Doooooooove/Medical-Electrical-Stimulator-STM32/hardware/README.md

# 硬件资料与连接

## 已包含的资料

- [电流板原理图](电流板原理图_Howland恒流源.pdf)：电压转电流与升压电路资料。
- [电流板 PCB 3D](电流板PCB_3D.pdf)：PCB 外观资料。
- [原型连线实拍](../docs/assets/prototype-bench.jpeg)：课程答辩第 18 页。
- [阻抗检测连接实拍](../docs/assets/impedance-bench.jpeg)：课程答辩第 11 页。

原 README 曾列出 STM32 核心板原理图，但当前仓库未包含该文件。板卡版本、完整 BOM、可编辑 PCB 工程和核心板原理图仍需后续补齐。

## 硬件链路

答辩材料中的驱动链路由 LM5158 升压级和 OPA551UA / BCP56 Howland 恒流级组成，标称升压轨为 54 V。实际输出能力取决于供电、负载与器件状态，不能仅用电源轨电压作为负载端能力指标。

负载电压通过 100 kΩ 与 4.7 kΩ 分压后送入 ADC。电阻负载与分压支路并联，固件对 104.7 kΩ 支路的影响进行补偿。

## 当前固件引脚

| 用途 | STM32 引脚 | 外设连接 |
| --- | --- | --- |
| 模拟控制 | PA4 / DAC1 | 恒流板控制输入 |
| 电压采样 | PA0 / ADC1_IN0 | 分压网络采样点 |
| 触屏发送 | PA2 / USART2_TX | 触屏 RX |
| 触屏接收 | PA3 / USART2_RX | 触屏 TX |
| 无线发送 | PB10 / USART3_TX | ESP32-C3 RX |
| 无线接收 | PB11 / USART3_RX | ESP32-C3 TX |
| 参考地 | GND | 按原理图和模块要求连接 |

两路 STM32 串口均为 9600 bps、8N1。ESP32-C3 实际串口管脚和模块供电应按具体板型核对，不从裸芯片名称推断模块接口。

## 台架记录

答辩第 8 页的标定使用标称 2.2 kΩ 电阻，课程任务要求中的负载为 2 kΩ，二者应分别记录。当前照片和表格未完整提供负载实测值、容差、探测位置及仪器设置，详见[实验记录](../docs/validation.md)。

本仓库按电阻负载教学原型说明，不提供人体连接或治疗操作指南。
