Doooooooove/Medical-Electrical-Stimulator-STM32/docs/assets/README.md

# 实物图片来源

以下图片直接从维护者提供的《工创答辩》PPTX 的内嵌媒体中提取，保留原始字节，不裁切、不重绘，不修改读数。答辩封面日期为 2026-10-10，源文件 SHA-256 记录于 [实验记录](../validation.md)。

| 仓库文件 | 答辩页码 | PPTX 内嵌媒体 |
| --- | --- | --- |
| [prototype-bench.jpeg](prototype-bench.jpeg) | 18 | ppt/media/image35.jpeg |
| [scope-square.jpeg](scope-square.jpeg) | 7；同图另见 10 | ppt/media/image18.jpeg |
| [scope-exponential.jpeg](scope-exponential.jpeg) | 7、15 | ppt/media/image19.jpeg |
| [touchscreen.png](touchscreen.png) | 9 | ppt/media/image21.png |
| [impedance-bench.jpeg](impedance-bench.jpeg) | 11 | ppt/media/image26.jpeg |

这些是课程历史照片，不表示当前源码已完成复测。照片来源与软件版本分别记录。

图片权利归原权利人所有；第三方仪器与部件标识仅随实物照片出现。本次整理不额外发布包含学号和团队分工页的完整 PPT。

## Extracted image SHA-256

```text
prototype-bench.jpeg: d52561f0c2eb018fa2cf3d38755b160d2dafed0dc0a3548ff5372a9f7d169658
scope-square.jpeg: 8931f059186a53c1ad5a8b8f80eaf74cf128d25edcdfc1fe09eeaeb757da040e
scope-exponential.jpeg: 681918e8823cc99c03120ba20e04e832273ad1942c9be3908cb53f4bc3bec9cc
touchscreen.png: 769799a62ef4ccf7984dece17407666eeb5f1e26c6af2486228516d80676e821
impedance-bench.jpeg: 8b1d1d3e5d0a7fedc9b798ba3a578a7925597c38ae3c7afd09415009087dfd3e
```
