Doooooooove/Medical-Electrical-Stimulator-STM32/docs/portfolio.md

# 项目简述：STM32 可编程电刺激教学原型

## 项目背景与个人工作

南京航空航天大学智能医疗实践课程，2026-10-10 结题答辩。维护者高申独立完成硬件搭建与焊接、固件集成、触屏和无线模块联调、示波器测量及标定，使用 AI 辅助代码开发。

项目目标是把 MCU 控制、恒流驱动、采样和交互接通，形成可操作的教学原型。

## 实现内容

| 工作 | 具体实现 | 可查看材料 |
| --- | --- | --- |
| 模拟链路与硬件联调 | STM32、Howland 恒流级、分压采样及外设连接 | [连线实拍](assets/prototype-bench.jpeg)、[硬件资料](../hardware/README.md) |
| 实时输出 | TIM1 回调计算波形并更新片内 DAC | [固件说明](../firmware/README.md) |
| 标定补偿 | 十一点 DAC 表及线性插值 | [设计说明](医疗电刺激系统设计与实验报告.md) |
| 采样计算 | ADC 均值、分压还原与并联支路补偿 | [设计说明](医疗电刺激系统设计与实验报告.md) |
| 交互集成 | 串口屏、ESP32-C3 网页与短命令协议 | [HMI](../hmi/README.md)、[无线协议](../wireless/readme.md) |
| 测量与记录 | 方波及指数波实拍，电流标定表 | [验证记录](validation.md) |

## 实验结果及边界

答辩第 8 页包含标称 2.2 kΩ 负载下十个 1–10 mA 设定点。按记录电压重新计算，最大绝对相对偏差约 0.0455%。该数值限于这组表格，不包含负载容差与仪器不确定度，不作为通用精度指标。

维护者已在 Keil 中完成编译并完成原型实测，示波器实拍展示了方波与平滑上升、指数衰减形态。当前展示材料没有逐项列出固件哈希与测量配置，可在归档时补充，方便他人复现。

## 可深入交流的技术点

- 电压转电流链路的输出余量、负载变化与饱和现象。
- DAC 逐点标定和插值对模拟链路误差的补偿。
- 分压支路并联负载对阻抗估计的影响及补偿公式。
- 输出中断与低速串口、触屏业务的调度关系。
- 代码、界面预览与实际端口测量之间的一致性验证。

项目材料支持嵌入式、仪器测试、数据采集与设备软件方向的实习交流。当前成果定位为教学与工程原型。
