Doooooooove/Medical-Electrical-Stimulator-STM32/docs/医疗电刺激系统设计与实验报告.md

# 可编程电刺激教学原型：设计与实验说明

## 1. 项目与实现范围

本项目来自南京航空航天大学智能医疗实践课程，2026-10-10 结题答辩。高申独立完成硬件搭建、焊接、固件集成、外设联调和测量标定，代码开发使用 AI 辅助。维护者已在 Keil 中完成编译，并完成原型实测。

原型以 STM32F103RCT6 为控制器，连接 Howland 恒流级、分压采样、串口触屏及 ESP32-C3。课程任务包括恒流、指数衰减波、带直偏的方波、阻抗检测和无线交互。

本文按当前源码描述实现。历史答辩照片、标定数字及其适用范围单独列于[实验记录](validation.md)。当前成果为教学和工程原型，不以课程展示替代产品认证或临床验证。

## 2. 硬件链路

```text
供电 → LM5158 升压 → Howland 恒流级 → 电阻负载
                       ↑                 ↓
                   PA4 / DAC       电阻分压 → PA0 / ADC
```

答辩材料标注的升压轨为 54 V，恒流级使用 OPA551UA / BCP56。分压支路为 100 kΩ + 4.7 kΩ。实物与图纸见[硬件目录](../hardware/README.md)。

供电轨与实际负载输出是不同测量量。输出电流、饱和范围和负载依赖关系应以明确测点的记录为准。

## 3. 输出中断与业务循环

当前 `tim.c` 的 TIM1 配置为 Prescaler = 71、Period = 49。按 72 MHz 定时器时钟计算：

```text
f_update = 72000000 / (71 + 1) / (49 + 1) = 20000 Hz
T_update = 50 μs
```

TIM1 回调维护时基，计算目标电流，经标定函数换算为 DAC 码并更新片内 DAC。主循环执行触屏解析、无线命令、ADC 采样和页面绘图。

该分工减少通信直接进入波形回调的情况，但当前主循环仍有阻塞发送、ADC 轮询及页面延时。ISR 中的浮点运算开销、最坏执行时间和实际时序应进一步测量，不能仅凭架构图宣称硬实时性能已证明。

答辩材料中的 1 kHz 描述属于历史架构，当前代码与历史照片的对应版本尚未记录。

## 4. 电流标定与插值

当前标定 DAC 码为：

```text
电流 / mA:  0    1    2    3    4     5     6     7     8     9    10
DAC 码:     0  194  418  628  837  1047  1256  1466  1675  1884  2095
```

`Current_To_DAC()` 先确定相邻整数电流点，再做线性插值与码值限制：

```text
D(I) = D_i + (D_(i+1) − D_i) × (I − I_i) / (I_(i+1) − I_i)
```

表项是对具体模拟链路的校准，不保证不同板卡和负载具有相同转换关系。答辩第 8、16 页的两组记录单独保存，测量偏差计算见[实验记录](validation.md)。

## 5. 波形模式

### 恒流

`MODE_CONSTANT_I` 将当前设定电流交给 DAC 换算函数，用于恒流演示与标定。当前界面通常以 1 mA 步进调整，软件插值本身支持非整数输入。

### 平滑上升与指数衰减

`MODE_EXPONENTIAL` 在周期起始阶段使用 sin² 上升，随后按时间常数指数衰减，小于阈值时置零。当前上升时间为 2.0 ms 或 0.5 ms，随代码条件选择。

指数模式不通过 `pulse_width_us` 独立截断输出；界面有脉宽参数不代表每个模式都使用它。波形形式不自动证明生理机制、舒适性或治疗效果。

### 带直偏的两电平方波

`MODE_BIPHASIC_DC` 根据 `dc_offset_mA ± current_mA / 2` 产生两个电平，间歇期回到偏置值，最终目标电流限制在 0–10 mA。

因此，代码中的“双向”名称不能直接作为端口反向电流或净电荷为零的依据。负载端波形、测量参考与完整周期积分需要单独验证。

### 梯形包络演示

`MODE_NMES_SWALLOW` 使用固定的 8 s 包络周期与 20 ms 内部脉冲周期。该分支不使用通用频率和脉宽参数决定载波。模式名称沿用课程场景，不提供临床操作含义。

## 6. 阻抗估计与并联补偿

当前主循环在非波形查看页、运行且满足设定电流条件时执行 ADC 采样；最多读取 16 次，并按成功采样数取平均。分压还原与计算关系为：

```text
V_PA0 = ADC_average / 4095 × 3.3
V_load = V_PA0 × 22.2766
R_parallel = V_load / (I_set_mA × 0.001)
R_load = R_parallel × 104700 / (104700 − R_parallel)
```

此处 `I_set` 是设定值。它不是独立采样的瞬时负载电流，动态波形、输出饱和及测量时刻都可能影响换算的有效性。

代码对结果做 0–50000 Ω 数值限制，没有据此完成自动测试电流换挡、全范围精度验证或开路关断。当前只能确认补偿计算的存在。

## 7. 触屏与无线通信

| 外设 | 当前链路 |
| --- | --- |
| 陶晶驰触屏 | USART2，PA2/PA3，9600 bps、8N1 |
| ESP32-C3 | USART3，PB10/PB11，9600 bps、8N1 |
| 无线网页 | LuatOS Wi-Fi 热点及 HTTP 服务 |

触屏用于设置参数、模式和状态显示。波形页按模型参数绘图，不是 ADC 数据流。

ESP32-C3 通过 `#` 前缀短命令请求状态和设置参数。具体 HTTP 路径与串口映射见[无线说明](../wireless/readme.md)。当前网页中的姓名和方案为静态演示内容，未实现真实病历系统。

软件停止经网络和串口进入主循环，再影响输出回调；它不能被描述为已验证的硬件急停。

## 8. 当前验证材料

- 完整原型、触屏与阻抗检测连接照片。
- 方波和平滑上升、指数衰减波的示波器照片。
- 第 8 页标称 2.2 kΩ 负载下十点电压记录，可重算相对偏差。
- 第 16 页另一组电流记录，单独转录。

照片不绑定当前固件版本，完整仪器设置、重复测量与不确定度记录尚未提供。现有材料的数值和限制见[实验记录](validation.md)。

## 9. 可补充的复现记录

为便于他人复现，可将已有编译与实测结果按以下项目归档：

1. Keil 工具链版本、构建与烧录记录，以及对应源码和固件哈希。
2. 课程要求 2 kΩ 条件与已有 2.2 kΩ 条件各自的测试记录。
3. 各模式的频率、脉宽、幅值与测点信息。
4. 上电、倒计时、软件停止与通信压力下的行为。
5. 阻抗估计在恒流、动态输出及页面切换条件下的有效性。

本次整理修正了文档、补充历史证据，并删除一处会影响编译的多余字符；未更改输出算法或控制流程，也未新增硬件验证结论。
