Doooooooove/Medical-Electrical-Stimulator-STM32/docs/validation.md

# 实验记录与验证范围

维护者已使用 Keil 完成工程编译，并完成原型实测。本页整理课程答辩记录、当前源码实现和可补充的复现信息，来源为维护者提供的《工创答辩》PPTX，封面日期 2026-10-10。此次助手仅核对已有材料，没有重新操作硬件；文中的归档缺项不表示维护者尚未做过相应测试。

## 来源索引

| 材料 | 页码 | 仓库记录 |
| --- | --- | --- |
| 课程要求：2 kΩ、0–10 mA、步进 ≤1 mA、精度 ≤±5% | 3、21 | 任务指标，不能直接视为实测结果 |
| 波形与示波器照片 | 7、10、15 | [方波](assets/scope-square.jpeg)、[指数波](assets/scope-exponential.jpeg) |
| 2.2 kΩ 负载标定表 | 8 | [电压转录数据](../data/defense-slide08-current-calibration.csv) |
| 触屏实物 | 9 | [触屏照片](assets/touchscreen.png) |
| 阻抗检测连接 | 11 | [连接照片](assets/impedance-bench.jpeg) |
| 系统标定与插值说明及另一组实测电流 | 16 | [电流转录数据](../data/defense-slide16-current-calibration.csv) |
| 完整原型连线 | 18 | [原型照片](assets/prototype-bench.jpeg) |

PPTX 源文件 SHA-256：99be5e32c3867f574721e524b00ea92c2459a17c4bd27d12bc1a4744a72f6a02。

新增图片从原 PPTX 提取，哈希和媒体位置见[图片清单](assets/README.md)。未发布答辩封面和人员分工页。

## 第 8 页：电压记录的重新计算

表中负载为标称 2.2 kΩ。使用原始显示电压计算，不从已四舍五入的电流列反算：

```text
I_estimated (mA) = V_measured (V) / 2200 (Ω) × 1000
relative_deviation (%) = (I_estimated − I_set) / I_set × 100
```

| 设定电流 / mA | 记录电压 / V | 计算电流 / mA | 相对偏差 / % |
| ---: | ---: | ---: | ---: |
| 1 | 2.201 | 1.000455 | +0.045455 |
| 2 | 4.401 | 2.000455 | +0.022727 |
| 3 | 6.601 | 3.000455 | +0.015152 |
| 4 | 8.798 | 3.999091 | −0.022727 |
| 5 | 11.003 | 5.001364 | +0.027273 |
| 6 | 13.200 | 6.000000 | +0.000000 |
| 7 | 15.405 | 7.002273 | +0.032468 |
| 8 | 17.602 | 8.000909 | +0.011364 |
| 9 | 19.797 | 8.998636 | −0.015152 |
| 10 | 22.002 | 10.000909 | +0.009091 |

该表最大绝对相对偏差为 **0.045455%**，发生于 1 mA 设定点。原 PPT 的“最大约 ±0.10%”属于较宽的概括，本页保留逐项计算结果。

以上只是对已有数字的重算，不增加测量精度。CSV 另外保留 PPT 展示的电流和误差列，避免丢失原来的四舍五入信息。

## 第 16 页：另一组电流记录

该页展示的实测电流依次为：

| 设定电流 / mA | PPT 记录电流 / mA |
| ---: | ---: |
| 0 | 0 |
| 1 | 0.999 |
| 2 | 2.001 |
| 3 | 2.999 |
| 4 | 4.002 |
| 5 | 5.000 |
| 6 | 6.002 |
| 7 | 6.999 |
| 8 | 8.001 |
| 9 | 8.998 |
| 10 | 10.001 |

非零设定点的最大绝对相对偏差为 **0.100000%**。零设定点只计算绝对偏差，不能除以零计算相对偏差。该页未明确标出负载及完整测量条件，不能将第 8 页的 2.2 kΩ 条件自动套用到这一组。

两页数据都保留，不取平均、不拼接为一次实验，不将其当作仪器原始采样文件。

## 已有材料可以说明什么

- 已有系统连线、触屏和示波器照片，支持“已完成可操作原型联调”的课程记录。
- 波形照片可用于观察方波和指数衰减形态，仪器有约 20 Hz 的频率显示。
- 两组电流表可以复核数值计算，支持讨论逐点标定与插值。
- 当前源码可定位 DAC 表、ADC 均值采样、分压补偿和串口命令。

## 尚不能从现有材料推导的结论

- 全量程、全负载、温漂和长期稳定性下的输出精度。
- 50 kΩ 测量上限及全量程 <0.2% 的阻抗精度。源码中的 50000 Ω 是结果限幅。
- 实际负载端负向电流、零净电荷、医疗电气标准合规或临床效果。
- 页面绘图等同于端口采样波形，或历史照片就是当前固件的复测。
- 通信失效、故障状态和软件停止的最坏响应时间。

现有资料未完整包含负载实测值与容差、供电记录、探头位置与倍率、仪器量程与校准状态、重复测量次数、环境温度，以及烧录固件的版本标识。

## 当前代码与答辩描述的差异

| 项目 | 答辩或旧说明 | 当前源码依据 |
| --- | --- | --- |
| 输出中断 | 1 kHz、1 ms | TIM1：Prescaler 71、Period 49；72 MHz 时钟下为 20 kHz、50 μs |
| 串口 | 旧 README 为 USART1/2、115200 bps | USART2 与 USART3，均为 9600 bps |
| DAC 通道 | 答辩第 16 页写 SPI 写入 | 片内 DAC 寄存器写入 |
| 指数波上升 | 旧 README 为 4 ms | 回调内为 2.0 ms 或 0.5 ms |
| 无线方式 | 答辩总结有“蓝牙”字样 | Lua 实现 Wi-Fi SoftAP + HTTP |
| 波形预览 | 部分表述为实时波形 | 按参数绘制，非 ADC 实时波形 |
| 故障处理 | 答辩架构图含故障锁存 | 当前代码未形成完整自动故障锁存状态机 |
| 保护与精度 | 旧说明声称开路关断、动态换挡及全范围精度 | 不能从当前实现及记录确认这些声明 |

源码入口：[main.c](../firmware/STM32_YLDZ_Project/Core/Src/main.c)、[tim.c](../firmware/STM32_YLDZ_Project/Core/Src/tim.c)、[usart.c](../firmware/STM32_YLDZ_Project/Core/Src/usart.c)、[main.lua](../wireless/main.lua)。

## 当前行为与待验证项

本次整理保留运行逻辑，只修正头文件引用后的多余字符及一处过期定时器注释。

| 当前行为或缺口 | 便于他人复现的记录 |
| --- | --- |
| 默认 `is_running = 1`、设定电流 5 mA | 上电、复位到稳定输出的全过程 |
| 倒计时归零后复位到 1200 s | 到时行为与期望的流程是否一致 |
| 停止命令经 HTTP、串口与主循环执行 | 命令发出至 DAC 输出归零的延迟，主循环负载下的最坏情况 |
| 两电平方波含直偏且负值钳为零 | 明确测点与电流方向，记录整个周期，而非仅看屏幕预览 |
| ADC 使用设定电流计算阻抗，且波形查看页不执行这段采样 | 分别记录恒流、动态输出和页面切换下的测量有效性 |
| 中断含浮点三角函数和指数函数 | ISR 执行时长、输出时序及通信压力下的变化 |
| 无线热点固定演示口令、无应用层身份验证 | 保持隔离台架演示，后续设计访问与命令确认机制 |
| HEX 与当前源码的对应关系不明确 | 用当前源码重新构建，保存工具链版本与固件哈希 |

为便于他人复现，可将已有测试按固定负载、仪器配置及固件版本归档。课程要求中的 2 kΩ 记录与第 8 页的 2.2 kΩ 记录应分别列出。

## 复核方法

在仓库根目录运行：

```sh
python3 tools/calibration_summary.py
```

脚本仅重新计算两组 CSV，使用 Python 3 标准库。它不验证硬件、不生成新的实测数据，也不将标定记录升级为认证报告。
