Doooooooove/Medical-Electrical-Stimulator-STM32/data/defense-slide08-current-calibration.csv

source_slide | set_current_mA | nominal_load_ohm | reported_voltage_V | reported_current_mA | reported_relative_error_percent
8 | 1.00 | 2200 | 2.201 | 1.0005 | +0.045
8 | 2.00 | 2200 | 4.401 | 2.0005 | +0.023
8 | 3.00 | 2200 | 6.601 | 3.0005 | +0.015
8 | 4.00 | 2200 | 8.798 | 3.9991 | -0.023
8 | 5.00 | 2200 | 11.003 | 5.0014 | +0.027
8 | 6.00 | 2200 | 13.200 | 6.000 | 0.000
8 | 7.00 | 2200 | 15.405 | 7.0023 | +0.032
8 | 8.00 | 2200 | 17.602 | 8.0009 | +0.011
8 | 9.00 | 2200 | 19.797 | 8.9986 | -0.015
8 | 10.00 | 2200 | 22.002 | 10.0009 | +0.009
