Doooooooove/Medical-Electrical-Stimulator-STM32/data/defense-slide16-current-calibration.csv

source_slide | set_current_mA | reported_current_mA
16 | 0 | 0
16 | 1 | 0.999
16 | 2 | 2.001
16 | 3 | 2.999
16 | 4 | 4.002
16 | 5 | 5.000
16 | 6 | 6.002
16 | 7 | 6.999
16 | 8 | 8.001
16 | 9 | 8.998
16 | 10 | 10.001
