Doooooooove/Medical-Electrical-Stimulator-STM32/hardware/电流板原理图_Howland恒流源.pdf

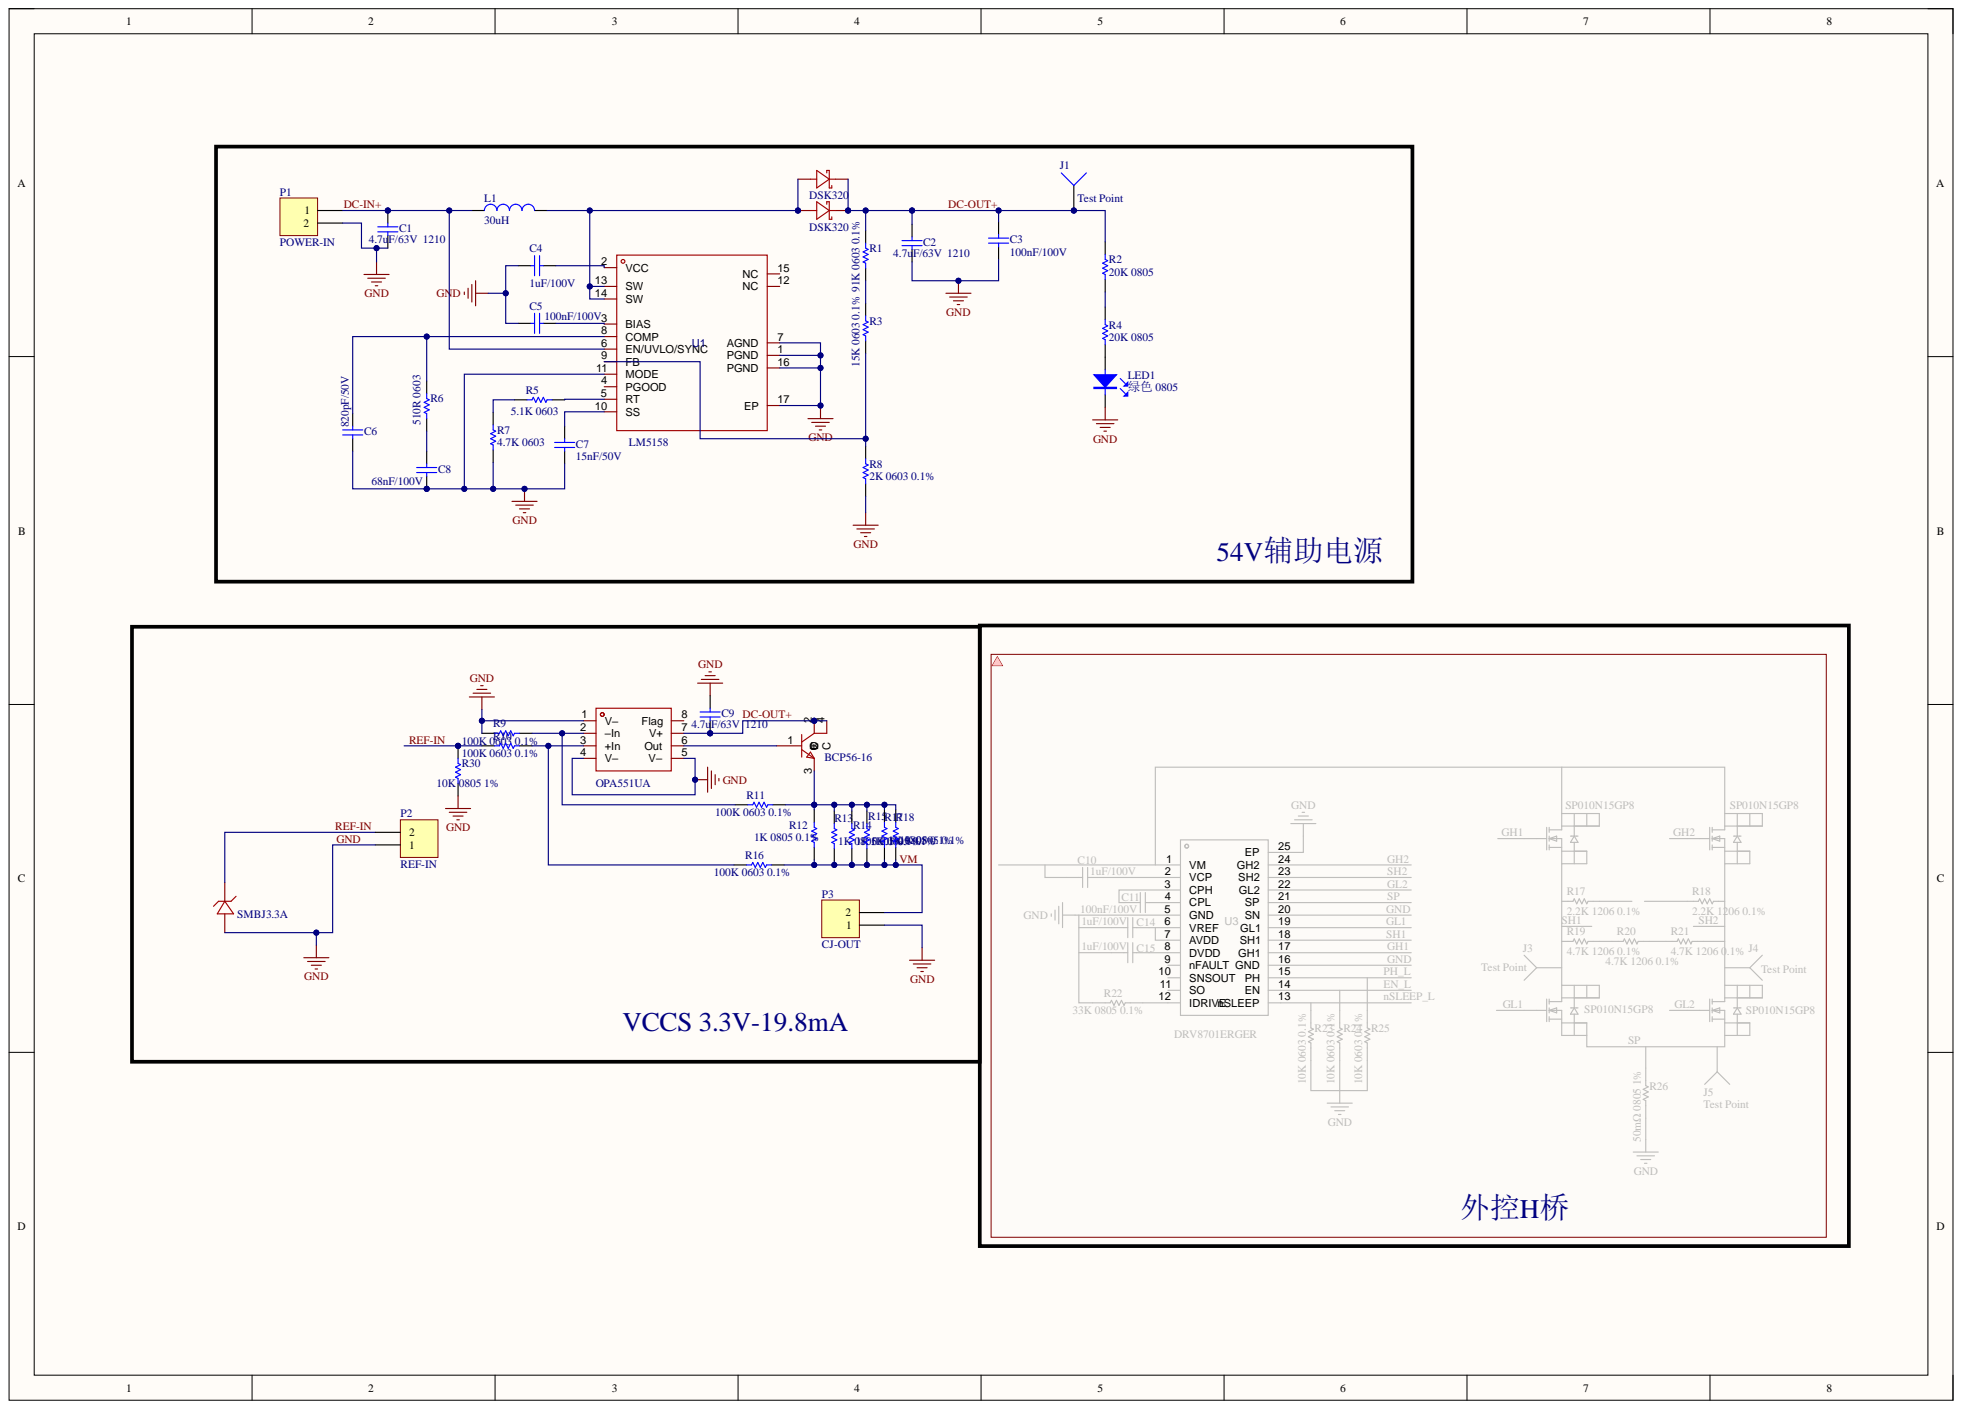
[picture p28: page 1]

MODE 11

R5 | PGOOD 4

Comment | Description | Designator | Footprint | LibRef | Quantity
4.7uF/63V 1210 | Capacitor | C1, C2, C9 | 1210C | Cap | 3
100nF/100V | Capacitor | C3, C5 | C0805 | Cap | 2
1uF/100V | Capacitor | C4 | C0805 | Cap | 1
820pF/50V | Capacitor | C6 | C0805 | Cap | 1
15nF/50V | Capacitor | C7 | C0805 | Cap | 1
68nF/100V | Capacitor | C8 | C0805 | Cap | 1
DSK320 | | D1, D2 | SOD123F | DSK320_C28646292 | 2
SMBJ3.3A | | D3 | SMB/DO-214AA | SMBJ3.3A_C1907755 6 | 1
Test Point | Socket | J1 | TEST POINT | Socket | 1
30uH | Inductor | L1 | 贴片电感-0630 | Inductor | 1
绿色 0805 | | LED1 | 0805D | LED | 1
POWER-IN | Header, 2-Pin | P1 | HD1X2 | Header 2 | 1
REF-IN | Header, 2-Pin | P2 | HD1X2 | Header 2 | 1
CJ-OUT | Header, 2-Pin | P3 | HD1X2 | Header 2 | 1
BCP56-16 | | Q1 | SOT-223 | BCP56-16,115 | 1
91K 0603 0.1% | Resistor | R1 | 0603R | Res1 | 1
20K 0805 | Resistor | R2, R4 | 0805R | Res1 | 2
15K 0603 0.1% | Resistor | R3 | 0603R | Res1 | 1
5.1K 0603 | Resistor | R5 | 0603R | Res1 | 1
510R 0603 | Resistor | R6 | 0603R | Res1 | 1
4.7K 0603 | Resistor | R7 | 0603R | Res1 | 1
2K 0603 0.1% | Resistor | R8 | 0603R | Res1 | 1
100K 0603 0.1% | Resistor | R9, R10, R11, R16 | 0603R | Res1 | 4
1K 0805 0.1% | Resistor | R12, R13, R14, R15, R17, R18 | 0805R | Res1 | 6
10K 0805 1% | Resistor | R30 | 0805R | Res1 | 1
LM5158 | | U1 | QFN16-0.5MM | LM5158RTER | 1
OPA551UA | | U2 | SOP-8 | OPA551UA/2K5 | 1
