Doooooooove/Medical-Electrical-Stimulator-STM32/firmware/STM32_YLDZ_Project/Core/Inc/main.h

#define LED1_Pin GPIO_PIN_8
#define LED1_GPIO_Port GPIOA
