Doooooooove/Medical-Electrical-Stimulator-STM32/(notices)

Notices in the files:
firmware/STM32_YLDZ_Project/Core/Inc/main.h:
Copyright (c) 2026 STMicroelectronics.
All rights reserved.
This software is licensed under terms that can be found in the LICENSE file
